doinbest/25-e-Qd4310-/docs/硬件资料/小车结构1.jpg

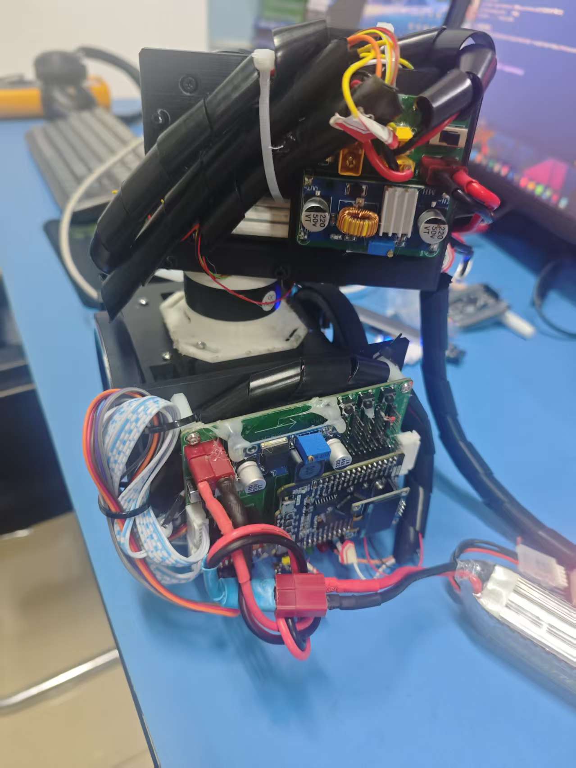
docs/硬件资料/小车结构1.jpg
