doinbest/25-e-Qd4310-/README.md

# 2025 年电赛 E 题 QD4310 无刷电机项目

## 项目简介

本项目用于 2025 年全国大学生电子设计竞赛 E 题相关开发。

系统由 STM32 主控、QD4310 无刷电机、MaixCAM2 视觉模块及相关传感器组成。
STM32 负责模式管理、控制算法、安全保护和电机执行；
MaixCAM2 负责视觉识别，并通过串口向 STM32 发送识别结果。

## 目录说明

```text
docs/                 题目、器件手册、接线图、协议与调试记录
stm32/                当前使用的 STM32 工程
maixcam2/             当前使用的 MaixCAM2 脚本
reference/            历史版本和参考工程，仅供查阅
AGENTS.md             项目开发约束与协作规则
