doinbest/25-e-Qd4310-/maixcam2/云台联调说明.md

# MaixCAM2 与 STM32 云台联调说明（V1）

对应程序：`main.py`。本版只传输靶心像素误差和 MaixCAM2 板载
`LSM6DSOWTR` 三轴角速度；不识别红色激光点，也不使用 JY901S、姿态角或
Z 轴硬件清零命令。

## 硬件与频率

| 项目 | 配置 |
|---|---|
| MaixCAM2 UART | UART4，`/dev/ttyS4`，115200 / 8N1 |
| 连线 | A21 TX → STM32 PB11 USART3 RX；A22 RX ← STM32 PB10 USART3 TX；两端共地 |
| IMU | 板载 LSM6DSOWTR，`GYRO_ONLY`，±1000 dps，ODR 416 Hz |
| IMU 帧 | 5 ms 一帧，即 200 Hz |
| 视觉帧 | 视觉处理完成后发送，最大 100 Hz |
| STM32 控制帧 | 10 ms 一帧，即 100 Hz；激光状态改变时立即补发 |

首次启动若没有校准文件，MaixCAM2 要保持静止 10 秒。程序保存陀螺零偏；以后
启动自动加载。B3 激光默认关闭，只有接收到 CRC 正确且 `FLAGS.bit0=1` 的控制帧才打开。

## 统一帧格式

所有多字节字段均为大端序，浮点数均为 IEEE-754 `float32` 大端序。

```text
55 AA | VER | TYPE | FLAGS | SEQ | LEN | PAYLOAD | CRC16_H CRC16_L
```

- `VER = 0x01`
- `SEQ` 为同一发送端的 8 位递增序号，`255 → 0` 正常回绕。
- CRC 为 `CRC-16/CCITT-FALSE`：poly `0x1021`、init `0xFFFF`、不反射、xorout `0x0000`。
- CRC 覆盖 `VER` 至 payload 最后一个字节，不包括 `55 AA` 和 CRC 本身。

| 方向 | TYPE | LEN | payload | 总长度 |
|---|---:|---:|---|---:|
| MaixCAM2 → STM32 | `0x01` | 9 | `error_x_px:f32`、`error_y_px:f32`、`applied_control_seq:u8` | 18 B |
| MaixCAM2 → STM32 | `0x02` | 12 | `gyro_x_dps:f32`、`gyro_y_dps:f32`、`gyro_z_dps:f32` | 21 B |
| STM32 → MaixCAM2 | `0x81` | 3 | `mode:u8`、`circle_progress:u16` | 12 B |

### FLAGS

- 视觉帧：bit0 靶心有效；bit1 靶面映射有效；bit2 已锁定；bit3 自上一视觉帧以来收到新控制帧。
- IMU 帧：bit0 IMU 数据有效；bit1 零偏校准已加载或已完成。
- 控制帧：bit0 激光授权。

`mode` 定义为 `0=IDLE`、`1=CENTER`、`2=CIRCLE`。本阶段 MaixCAM2 只回显其序号、
接收激光授权；圆周进度尚不参与视觉误差计算。

## 控制量定义

视觉端固定计算：

```text
error_x_px = AIM_CENTER_X - target_center_x
error_y_px = AIM_CENTER_Y - target_center_y
```

STM32 像素 PID 目标为零，等价使用 `actual = -error_px`，因此保持原有 PID
正负关系。两轴最终正方向必须在空载低速测试中确认；当前配置只是初始轴映射。

```text
像素误差 → STM32 像素 PID → 目标云台角速度 rpm
目标角速度 - (gyro_dps / 6) → STM32 IMU 速度 PID → QD4310 速度指令 rpm
QD4310 内部速度环 → 电流环 → 电磁力矩
```

STM32 仅向 QD4310 下发速度模式命令；本版没有修改 PID 增益、速度限幅或 QD4310 协议。

## 安全与联调

- STM32 只在视觉、IMU 都新鲜且有效时启用云台；视觉丢失帧会显式发送 `valid=0`。
- USART3 ISR 只写环形缓冲区；主循环完成版本、长度和 CRC 校验后才更新邮箱。
- 先不接电机检查三类帧、CRC 计数和激光授权；再低限幅分别手动转动两轴，确认 IMU 轴与符号；最后闭合像素外环。
- `protocol_v1_test.py` 含 CRC、float 大端、半包、粘包、错误 CRC、错误长度、垃圾字节和序号回绕测试。
