doinbest/25-e-Qd4310-/maixcam2/app.png

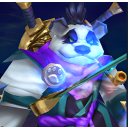
maixcam2/app.png
