doinbest/25-e-Qd4310-/stm32/25Qdrive无刷电机/21F 5.22 （巡线单灰度版本） - 副本/21F/21F/Hardware/PID/bsp_pid.h

#ifndef __BSP_PID_H
#define	__BSP_PID_H

typedef struct
{
    float target_val; // 目标值
    float actual_val; // 实际值

    float err;      // 当前偏差 e(k)
    float err_last; // 上一次偏差 e(k-1)
    float err_prev;   // 上上次偏差 e(k-2)，增量式PID使用

    float Kp, Ki, Kd; // PID参数

    float integral; // 积分值，位置式PID使用
    float output;   // PID输出值

} _pid;

extern _pid pid_speed, pid_speed2;
extern _pid pid_location;
extern _pid pid_angle;
extern _pid pid_graysensor;
extern _pid pid_dr4310X;
extern _pid pid_dr4310Y;
extern _pid pid_dr4310X_imu_rate;
extern _pid pid_dr4310Y_imu_rate;

void PID_param_init(void);
float Limit_Float(float val, float min, float max);
void PID_Reset(_pid *pid);
void PID_Clear_State(_pid *pid);

void set_pid_target(_pid *pid, float temp_val);
void set_speed_pid_target(_pid *pid, float temp_val);
float get_pid_target(_pid *pid);
void set_p_i_d(_pid *pid, float p, float i, float d);


float location_pid_realize(_pid *pid, float actual_val);
float speed_pid_realize(_pid *pid, float actual_val, float output_limit);
float angle_pid_realize(_pid *pid, float actual_val);
float gray_pid_realize(_pid *pid, float actual_val);
float pid_realize_limited(_pid *pid, float actual_val, float output_limit,
                          float integral_limit, float deadband);
float dr4310_pid_realize(_pid *pid, float actual_val, float output_limit);
float Angle_Error(float target, float actual);
#endif
