doinbest/25-e-Qd4310-/reference/单片机主控/21F （巡线 灰度+维特版本) - 改成最终版/21F 5.20/21F/21F/Hardware/motor/bsp_motor.h

#ifndef __BSP_MOTOR_H
#define __BSP_MOTOR_H

#include "main.h"

typedef enum
{
    MOTOR_LEFT = 0,
    MOTOR_RIGHT
} Motor_Id_t;

void Motor_Init(void);
void Motor_SetSpeed(Motor_Id_t motor, int16_t speed);
void Motor_Stop(void);



#endif
