doinbest/25-e-Qd4310-/stm32/25Qdrive无刷电机/21F 5.22 （巡线单灰度版本） - 副本/21F/21F/System/bsp_debug/protocol.c

/**
 ******************************************************************************
 * @file    protocol.c
 * @version V1.0
 * @date    2020-xx-xx
 * @brief   野火PID调试助手通讯协议解析
 ******************************************************************************
 * @attention
 *
 * 实验平台:野火 F103 开发板 
 * 论坛    :http://www.firebbs.cn
 * 淘宝    :https://fire-stm32.taobao.com
 *
 ******************************************************************************
 */ 

#include "protocol.h"
#include <string.h>
#include "control.h"
#include "maixcam.h"
#include "bsp_debug.h"
#include "tim.h"

uint8_t speed_select = 0; // 默认是 0 代表左轮

float set_point=0.0;

struct prot_frame_parser_t
{
   uint8_t *recv_ptr;
   uint16_t r_oft;
   uint16_t w_oft;
   uint16_t frame_len;
   uint16_t found_frame_head;
};

static struct prot_frame_parser_t parser;

static uint8_t recv_buf[PROT_FRAME_LEN_RECV];
static void Protocol_ClearDebugValues(void)
{
    int32_t zero = 0;

    set_point = 0.0f;

    PID_Reset(&pid_speed);
    PID_Reset(&pid_speed2);
    PID_Reset(&pid_location);
    PID_Reset(&pid_angle);

    /* This is common Wildfire/debug cleanup only.  Do not reset the local
       WIT-A here: STOP/page switching must reset WIT-B through MaixCam only. */
    Encoder_ResetDistance();

    speed_target_mm_s = 0;
    left_pwm = 0;
    right_pwm = 0;

    /* STOP explicitly clears the Wildfire target field once. */
    set_computer_value(SEND_TARGET_CMD, CURVES_CH1, &zero, 1);
    set_computer_value(SEND_FACT_CMD, CURVES_CH1, &zero, 1);
}

/**
 * @brief 计算校验和
 * @param ptr：需要计算的数据
 * @param len：需要计算的长度
 * @retval 校验和
 */
uint8_t check_sum(uint8_t init, uint8_t *ptr, uint8_t len )
{
 uint8_t sum = init;
 
 while(len--)
 {
   sum += *ptr;
   ptr++;
 }
 
 return sum;
}

/**
* @brief   得到帧类型（帧命令）
* @param   *frame:  数据帧
* @param   head_oft: 帧头的偏移位置
* @return  帧长度.
*/
static uint8_t get_frame_type(uint8_t *frame, uint16_t head_oft)
{
   return (frame[(head_oft + CMD_INDEX_VAL) % PROT_FRAME_LEN_RECV] & 0xFF);
}

/**
* @brief   得到帧长度
* @param   *buf:  数据缓冲区.
* @param   head_oft: 帧头的偏移位置
* @return  帧长度.
*/
static uint16_t get_frame_len(uint8_t *frame, uint16_t head_oft)
{
   return ((frame[(head_oft + LEN_INDEX_VAL + 0) % PROT_FRAME_LEN_RECV] <<  0) |
           (frame[(head_oft + LEN_INDEX_VAL + 1) % PROT_FRAME_LEN_RECV] <<  8) |
           (frame[(head_oft + LEN_INDEX_VAL + 2) % PROT_FRAME_LEN_RECV] << 16) |
           (frame[(head_oft + LEN_INDEX_VAL + 3) % PROT_FRAME_LEN_RECV] << 24));    // 合成帧长度
}

/**
* @brief   获取 crc-16 校验值
* @param   *frame:  数据缓冲区.
* @param   head_oft: 帧头的偏移位置
* @param   head_oft: 帧长
* @return  帧长度.
*/
static uint8_t get_frame_checksum(uint8_t *frame, uint16_t head_oft, uint16_t frame_len)
{
   return (frame[(head_oft + frame_len - 1) % PROT_FRAME_LEN_RECV]);
}

/**
* @brief   查找帧头
* @param   *buf:  数据缓冲区.
* @param   ring_buf_len: 缓冲区大小
* @param   start: 起始位置
* @param   len: 需要查找的长度
* @return  -1：没有找到帧头，其他值：帧头的位置.
*/
static int32_t recvbuf_find_header(uint8_t *buf, uint16_t ring_buf_len, uint16_t start, uint16_t len)
{
   uint16_t i = 0;

   for (i = 0; i < (len - 3); i++)
   {
       if (((buf[(start + i + 0) % ring_buf_len] <<  0) |
            (buf[(start + i + 1) % ring_buf_len] <<  8) |
            (buf[(start + i + 2) % ring_buf_len] << 16) |
            (buf[(start + i + 3) % ring_buf_len] << 24)) == FRAME_HEADER)
       {
           return ((start + i) % ring_buf_len);
       }
   }
   return -1;
}

/**
* @brief   计算为解析的数据长度
* @param   *buf:  数据缓冲区.
* @param   ring_buf_len: 缓冲区大小
* @param   start: 起始位置
* @param   end: 结束位置
* @return  为解析的数据长度
*/
static int32_t recvbuf_get_len_to_parse(uint16_t frame_len, uint16_t ring_buf_len,uint16_t start, uint16_t end)
{
   uint16_t unparsed_data_len = 0;

   if (start <= end)
       unparsed_data_len = end - start;
   else
       unparsed_data_len = ring_buf_len - start + end;

   if (frame_len > unparsed_data_len)
       return 0;
   else
       return unparsed_data_len;
}

/**
* @brief   接收数据写入缓冲区
* @param   *buf:  数据缓冲区.
* @param   ring_buf_len: 缓冲区大小
* @param   w_oft: 写偏移
* @param   *data: 需要写入的数据
* @param   *data_len: 需要写入数据的长度
* @return  void.
*/
static void recvbuf_put_data(uint8_t *buf, uint16_t ring_buf_len, uint16_t w_oft,
       uint8_t *data, uint16_t data_len)
{
   if ((w_oft + data_len) > ring_buf_len)               // 超过缓冲区尾
   {
       uint16_t data_len_part = ring_buf_len - w_oft;     // 缓冲区剩余长度

       /* 数据分两段写入缓冲区*/
       memcpy(buf + w_oft, data, data_len_part);                         // 写入缓冲区尾
       memcpy(buf, data + data_len_part, data_len - data_len_part);      // 写入缓冲区头
   }
   else
       memcpy(buf + w_oft, data, data_len);    // 数据写入缓冲区
}

/**
* @brief   查询帧类型（命令）
* @param   *data:  帧数据
* @param   data_len: 帧数据的大小
* @return  帧类型（命令）.
*/
static uint8_t protocol_frame_parse(uint8_t *data, uint16_t *data_len)
{
   uint8_t frame_type = CMD_NONE;
   uint16_t need_to_parse_len = 0;
   int16_t header_oft = -1;
   uint8_t checksum = 0;
   
   need_to_parse_len = recvbuf_get_len_to_parse(parser.frame_len, PROT_FRAME_LEN_RECV, parser.r_oft, parser.w_oft);    // 得到为解析的数据长度
   if (need_to_parse_len < 9)     // 肯定还不能同时找到帧头和帧长度
       return frame_type;

   /* 还未找到帧头，需要进行查找*/
   if (0 == parser.found_frame_head)
   {
       /* 同步头为四字节，可能存在未解析的数据中最后一个字节刚好为同步头第一个字节的情况，
          因此查找同步头时，最后一个字节将不解析，也不会被丢弃*/
       header_oft = recvbuf_find_header(parser.recv_ptr, PROT_FRAME_LEN_RECV, parser.r_oft, need_to_parse_len);
       if (0 <= header_oft)
       {
           /* 已找到帧头*/
           parser.found_frame_head = 1;
           parser.r_oft = header_oft;
         
           /* 确认是否可以计算帧长*/
           if (recvbuf_get_len_to_parse(parser.frame_len, PROT_FRAME_LEN_RECV,
                   parser.r_oft, parser.w_oft) < 9)
               return frame_type;
       }
       else 
       {
           /* 未解析的数据中依然未找到帧头，丢掉此次解析过的所有数据*/
           parser.r_oft = ((parser.r_oft + need_to_parse_len - 3) % PROT_FRAME_LEN_RECV);
           return frame_type;
       }
   }
   
   /* 计算帧长，并确定是否可以进行数据解析*/
   if (0 == parser.frame_len) 
   {
       parser.frame_len = get_frame_len(parser.recv_ptr, parser.r_oft);
       if ((parser.frame_len < 9) || (parser.frame_len > PROT_FRAME_LEN_RECV))
       {
           parser.r_oft = (parser.r_oft + 1) % PROT_FRAME_LEN_RECV;
           parser.frame_len = 0;
           parser.found_frame_head = 0;
           return frame_type;
       }
       if(need_to_parse_len < parser.frame_len)
           return frame_type;
   }

   /* 帧头位置确认，且未解析的数据超过帧长，可以计算校验和*/
   if ((parser.frame_len + parser.r_oft - PROT_FRAME_LEN_CHECKSUM) > PROT_FRAME_LEN_RECV)
   {
       /* 数据帧被分为两部分，一部分在缓冲区尾，一部分在缓冲区头 */
       checksum = check_sum(checksum, parser.recv_ptr + parser.r_oft, 
               PROT_FRAME_LEN_RECV - parser.r_oft);
       checksum = check_sum(checksum, parser.recv_ptr, parser.frame_len -
               PROT_FRAME_LEN_CHECKSUM + parser.r_oft - PROT_FRAME_LEN_RECV);
   }
   else 
   {
       /* 数据帧可以一次性取完*/
       checksum = check_sum(checksum, parser.recv_ptr + parser.r_oft, parser.frame_len - PROT_FRAME_LEN_CHECKSUM);
   }

   if (checksum == get_frame_checksum(parser.recv_ptr, parser.r_oft, parser.frame_len))
   {
       /* 校验成功，拷贝整帧数据 */
       if ((parser.r_oft + parser.frame_len) > PROT_FRAME_LEN_RECV) 
       {
           /* 数据帧被分为两部分，一部分在缓冲区尾，一部分在缓冲区头*/
           uint16_t data_len_part = PROT_FRAME_LEN_RECV - parser.r_oft;
           memcpy(data, parser.recv_ptr + parser.r_oft, data_len_part);
           memcpy(data + data_len_part, parser.recv_ptr, parser.frame_len - data_len_part);
       }
       else 
       {
           /* 数据帧可以一次性取完*/
           memcpy(data, parser.recv_ptr + parser.r_oft, parser.frame_len);
       }
       *data_len = parser.frame_len;
       frame_type = get_frame_type(parser.recv_ptr, parser.r_oft);

       /* 丢弃缓冲区中的命令帧*/
       parser.r_oft = (parser.r_oft + parser.frame_len) % PROT_FRAME_LEN_RECV;
   }
   else
   {
       /* 校验错误，说明之前找到的帧头只是偶然出现的废数据*/
       parser.r_oft = (parser.r_oft + 1) % PROT_FRAME_LEN_RECV;
   }
   parser.frame_len = 0;
   parser.found_frame_head = 0;

   return frame_type;
}

/**
* @brief   接收数据处理
* @param   *data:  要计算的数据的数组.
* @param   data_len: 数据的大小
* @return  void.
*/
void protocol_data_recv(uint8_t *data, uint16_t data_len)
{
   recvbuf_put_data(parser.recv_ptr, PROT_FRAME_LEN_RECV, parser.w_oft, data, data_len);    // 接收数据
   parser.w_oft = (parser.w_oft + data_len) % PROT_FRAME_LEN_RECV;                          // 计算写偏移
}

/**
* @brief   初始化接收协议
* @param   void
* @return  初始化结果.
*/
int32_t protocol_init(void)
{
   memset(&parser, 0, sizeof(struct prot_frame_parser_t));
   
   /* 初始化分配数据接收与解析缓冲区*/
   parser.recv_ptr = recv_buf;
 
   return 0;
}

/**
* @brief   接收的数据处理
* @param   void
* @return  -1：没有找到一个正确的命令.
*/
int8_t receiving_process(void)
{
 uint8_t frame_data[128];         // 要能放下最长的帧
 uint16_t frame_len = 0;          // 帧长度
 uint8_t cmd_type = CMD_NONE;     // 命令类型
 
 while(1)
 {
   cmd_type = protocol_frame_parse(frame_data, &frame_len);  
   if (cmd_type != CMD_NONE)
   {
     PID_Debug_LastCmd = cmd_type;
     PID_Debug_CmdCount++;
   }
   switch (cmd_type)
   {
     case CMD_NONE:
     {
       return -1;
     }

     case SET_P_I_D_CMD:
     {
       uint32_t temp0 = COMPOUND_32BIT(&frame_data[13]);
       uint32_t temp1 = COMPOUND_32BIT(&frame_data[17]);
       uint32_t temp2 = COMPOUND_32BIT(&frame_data[21]);

        float p_temp = *(float *)&temp0;
        float i_temp = *(float *)&temp1;
        float d_temp = *(float *)&temp2;
      
        if(Car_Mode == Speed_Mode)
        {
            set_p_i_d(&pid_speed, p_temp, i_temp, d_temp);    
        }
        else if(Car_Mode == Speed2_Mode)
        {
            set_p_i_d(&pid_speed2, p_temp, i_temp, d_temp);    
        }
        else if(Car_Mode == Location_Mode)
        {
            set_p_i_d(&pid_location, p_temp, i_temp, d_temp);
        }
        else if(Car_Mode == Angle_Mode)
        {
            set_p_i_d(&pid_angle, p_temp, i_temp, d_temp);
        }
        else if (Car_Mode == Gray_Mode)
        {
            set_p_i_d(&pid_graysensor, p_temp, i_temp, d_temp);
        }
        else if(Car_Mode == X_Mode)
        {
            set_p_i_d(&pid_dr4310X, p_temp, i_temp, d_temp);
            PID_Clear_State(&pid_dr4310X);
        }
        else if(Car_Mode == Y_Mode)
        {
            set_p_i_d(&pid_dr4310Y, p_temp, i_temp, d_temp);
            PID_Clear_State(&pid_dr4310Y);
        }
        else if(Car_Mode == X_Rate_Mode)
        {
            set_p_i_d(&pid_dr4310X_imu_rate, p_temp, i_temp, d_temp);
            PID_Clear_State(&pid_dr4310X_imu_rate);
        }
        else if(Car_Mode == Y_Rate_Mode)
        {
            set_p_i_d(&pid_dr4310Y_imu_rate, p_temp, i_temp, d_temp);
            PID_Clear_State(&pid_dr4310Y_imu_rate);
        }
    }
     break;

     case SET_TARGET_CMD:
     {		
        int actual_temp = COMPOUND_32BIT(&frame_data[13]);    // 得到数据

        if (Car_Mode == X_Mode)
        {
            gimbal_set_pixel_target(0U, (float)actual_temp);
            break;
        }
        if (Car_Mode == Y_Mode)
        {
            gimbal_set_pixel_target(1U, (float)actual_temp);
            break;
        }

        if ((Car_Mode == X_Rate_Mode) || (Car_Mode == Y_Rate_Mode))
        {
            set_point = actual_temp;
            if (Car_Mode == X_Rate_Mode)
            {
                set_pid_target(&pid_dr4310X_imu_rate, (float)actual_temp);
                gimbal_set_rate_target(0U, (float)actual_temp);
            }
            else
            {
                set_pid_target(&pid_dr4310Y_imu_rate, (float)actual_temp);
                gimbal_set_rate_target(1U, (float)actual_temp);
            }
            break;
        }

        /* Retained chassis debug modes accept targets from the Wildfire PC. */
        set_point = actual_temp;
        if (Car_Mode != Run_Mode)
        {
            control_debug_stop();
        }

        if (Car_Mode == Speed_Mode)
        {
            control_running = 1U;
            set_speed_pid_target(&pid_speed, set_point);
        }
        else if (Car_Mode == Speed2_Mode)
        {
            control_running = 1U;
            set_speed_pid_target(&pid_speed2, set_point);
        }
        else if (Car_Mode == Location_Mode)
        {
            control_running = 1U;
            set_pid_target(&pid_location, set_point);
        }
        else if (Car_Mode == Angle_Mode)
        {
            control_running = 1U;
            set_pid_target(&pid_angle, set_point);
        }
        else if (Car_Mode == Gray_Mode)
        {
            control_running = 1U;
            set_pid_target(&pid_graysensor, (float)actual_temp);
        }
        break;

#if 0 /* Legacy chassis target modes are no longer part of the gimbal mode cycle. */
        set_point = actual_temp;
        /* Clear PID state before applying a new target. */
        if (Car_Mode != Run_Mode)
        {
            control_debug_stop();
        }
        
        if(Car_Mode == Speed_Mode)
        {
            /* 零目标仍保持 10ms 速度环运行，由速度 PID 主动减速。 */
            control_running = 1;
            set_speed_pid_target(&pid_speed, set_point);
        }
        else if(Car_Mode == Speed2_Mode)
        {
            /* 零目标仍保持 10ms 速度环运行，由速度 PID 主动减速。 */
            control_running = 1;
            set_speed_pid_target(&pid_speed2, set_point);
        }
        else if(Car_Mode == Location_Mode)
        {
            control_running = 1;
            set_pid_target(&pid_location, set_point);
        }
        else if(Car_Mode == Angle_Mode)
        {
            control_running = 1;
            set_pid_target(&pid_angle, set_point); // 角度环和位置环共用一个 PID 结构体
        }
        }
        else if(Car_Mode == Gray_Mode)
        {
            /* 灰度巡线的目标恒为居中，速度由 B4 档位设置。 */
            set_pid_target(&pid_graysensor, 0.0f);
        }
#endif
     }
     break;
     
     case START_CMD:    // 野火助手启动当前调试环
     {
     {
        if (Car_Mode == X_Mode)
        {
            gimbal_start_pixel_debug(0U);
            break;
        }
        if (Car_Mode == Y_Mode)
        {
            gimbal_start_pixel_debug(1U);
            break;
        }
        if (Car_Mode == X_Rate_Mode)
        {
            gimbal_start_rate_debug(0U);
            break;
        }
        if (Car_Mode == Y_Rate_Mode)
        {
            gimbal_start_rate_debug(1U);
            break;
        }
        if (Car_Mode != Run_Mode)
        {
            control_debug_stop();
            if (Car_Mode == Location_Mode)
            {
                Encoder_ResetDistance();
            }
            control_running = 1;

}
     }
     }
     break;
     
     case STOP_CMD:
     {
         /* Stop is always a gimbal emergency stop, regardless of the page
            selected by the Wildfire assistant. */
         /* A non-blocking transaction first disables both motors, asks
            MaixCAM to zero yaw, then remains stopped after bit2 protection. */
         gimbal_request_stop();
         control_running = 0;

control_debug_stop();
         Protocol_ClearDebugValues();
     }
     break; 
     
     case RESET_CMD:
     {
       HAL_NVIC_SystemReset();          // 复位系统
     }
     break;
     
      case SET_PERIOD_CMD:  // 用作切换调参模式
      {
         control_running = 0;
          control_debug_stop();
          Car_Mode++;
          Car_Mode %= PID_MODE_COUNT;
          /* The selected page remains safely disabled until 0x13 bit2 first
             confirms the request, its yaw-zero guard ends, and three fresh
             samples rebuild the difference-speed history. */
          gimbal_request_mode(Car_Mode);
      }
     break;

     default: 
       return -1;
   }
 }
}

/**
 * @brief 设置上位机的值
 * @param cmd：命令
 * @param ch: 曲线通道
 * @param data：参数指针
 * @param num：参数个数
 * @retval 无
 */
#if 0 /* Replaced below: the old copy had statements swallowed by comments. */
void set_computer_value(uint8_t cmd, uint8_t ch, void *data, uint8_t num)
{
 uint8_t sum = 0;    // 校验和
 num *= 4;           // 一个参数 4 个字节
 
 static packet_head_t set_packet;
 
 set_packet.head = FRAME_HEADER;     // 包头 0x59485A53
 set_packet.len  = 0x0B + num;      // 包长
 set_packet.ch   = ch;              // 设置通道
 set_packet.cmd  = cmd;             // 设置命令
 
 sum = check_sum(0, (uint8_t *)&set_packet, sizeof(set_packet));       // 计算包头校验和
 sum = check_sum(sum, (uint8_t *)data, num);                           // 计算参数校验和
 
 HAL_UART_Transmit(&huart1, (uint8_t *)&set_packet, sizeof(set_packet), 0xFFFFF);    // 发送数据头
 HAL_UART_Transmit(&huart1, data, num, 0xFFFFF);                          // 发送参数
 HAL_UART_Transmit(&huart1, (uint8_t *)&sum, sizeof(sum), 0xFFFFF);                  // 发送校验和
}

#endif

void set_computer_value(uint8_t cmd, uint8_t ch, void *data, uint8_t num)
{
    uint8_t sum;
    packet_head_t set_packet;

    num *= 4U;
    set_packet.head = FRAME_HEADER;
    set_packet.len = (uint16_t)(0x0BU + num);
    set_packet.ch = ch;
    set_packet.cmd = cmd;

    sum = check_sum(0U, (uint8_t *)&set_packet, sizeof(set_packet));
    sum = check_sum(sum, (uint8_t *)data, num);
    HAL_UART_Transmit(&huart1, (uint8_t *)&set_packet,
                      sizeof(set_packet), 1000U);
    HAL_UART_Transmit(&huart1, (uint8_t *)data, num, 1000U);
    HAL_UART_Transmit(&huart1, &sum, 1U, 1000U);
}

/**********************************************************************************************/
