doinbest/25-e-Qd4310-/reference/单片机主控/21F （巡线 灰度+维特版本) - 改成最终版/21F 5.20/21F/21F/Hardware/drug/drug.h

#ifndef __DRUG_H
#define __DRUG_H

#include "headfile.h"

extern uint8_t drug_state;

void drug_scan(void);
uint8_t Drug_IsPresent(void);
uint8_t Drug_WaitPlace(void);
uint8_t Drug_WaitRemove(void);

#endif
