doinbest/25-e-Qd4310-/reference/单片机主控/21F （巡线 灰度+维特版本) - 改成最终版/21F 5.20/21F/21F/Hardware/OLED/bsp_oled.h

#ifndef _BSP_OLED_H_
#define _BSP_OLED_H_
#include <stdint.h>	
#include <stdbool.h>
#include "bsp_sys.h"
//单片机头文件
#include "stm32f1xx.h"

#include "oled_font.h"
#include "oled_bmp.h"





#define  u8 unsigned char                                                
#define  u32 unsigned int
#define OLED_CMD  0 //写命令
#define OLED_DATA 1 //写数据
#define OLED_MODE 0




//引脚定义：
//PB4 :OLED_SCLK;
//PB5：OLED_SDIN


#define OLED_SCLK_Clr() HAL_GPIO_WritePin(GPIOB,GPIO_PIN_4,GPIO_PIN_RESET);	
#define OLED_SCLK_Set() HAL_GPIO_WritePin(GPIOB,GPIO_PIN_4,GPIO_PIN_SET);

#define OLED_SDIN_Clr() HAL_GPIO_WritePin(GPIOB,GPIO_PIN_5,GPIO_PIN_RESET);
#define OLED_SDIN_Set() HAL_GPIO_WritePin(GPIOB,GPIO_PIN_5,GPIO_PIN_SET);

//OLED模式设置
//0:4线串行模式
//1:并行8080模式

#define SIZE 16
#define XLevelL     0x02
#define XLevelH     0x10
#define Max_Column  128
#define Max_Row     64
#define Brightness  0xFF
#define X_WIDTH     128
#define Y_WIDTH     64
//-----------------OLED端口定义----------------


//OLED控制用函数
void OLED_WR_Byte(unsigned dat,unsigned cmd);
void OLED_Display_On(void);
void OLED_Display_Off(void);
void OLED_Init(void);
void OLED_Clear(void);
void OLED_DrawPoint(u8 x,u8 y,u8 t);
void OLED_Fill(u8 x1,u8 y1,u8 x2,u8 y2,u8 dot);
void OLED_ShowChar(u8 x,u8 y,u8 chr,u8 Char_Size);
void OLED_ShowNum(u8 x,u8 y,u32 num,u8 len,u8 size);
void OLED_ShowString(u8 x,u8 y, u8 *p,u8 Char_Size);
void OLED_Set_Pos(unsigned char x, unsigned char y);
void OLED_ShowCHinese(u8 x,u8 y,u8 no);
void OLED_ShowCHinese1(u8 x,u8 y,u8 no);

void OLED_DrawBMP(unsigned char x0, unsigned char y0,unsigned char x1, unsigned char y1,unsigned char BMP[]);
void fill_picture(unsigned char fill_Data);
void Picture(void);
void IIC_Start(void);
void IIC_Stop(void);
void Write_IIC_Command(unsigned char IIC_Command);
void Write_IIC_Data(unsigned char IIC_Data);
void Write_IIC_Byte(unsigned char IIC_Byte);
void IIC_Wait_Ack(void);



#endif /* 9_6_OLED_OLED_H_ */
