doinbest/25-e-Qd4310-/stm32/25Qdrive无刷电机/21F 5.22 （巡线单灰度版本） - 副本/21F/21F/Hardware/usart4(jy901s)/jy61p.h

#ifndef __JY61P_H
#define __JY61P_H

#include "headfile.h"

void jy61p_ReceiveData(uint8_t RxData);
void JY61p_HardwareZeroYaw(void);
void JY61p_HardwareZero(void);

extern float Roll,Pitch, Yaw;

#endif
