doinbest/25-e-Qd4310-/(commit log)

2026-07-18 feat(vision): add maixcam2 imu uart v1
2026-07-18 fix(maixcam): disable reverse uart control
    [maixcam.c]
2026-07-19 fix(uart): throttle reverse control frames
    [maixcam.c]
